dgok50/ESPNTPServer/eagle/ESPNTPServer/ESPNTPServer.brd

## EAGLE design eagle/ESPNTPServer/ESPNTPServer.brd (2026-11-04)

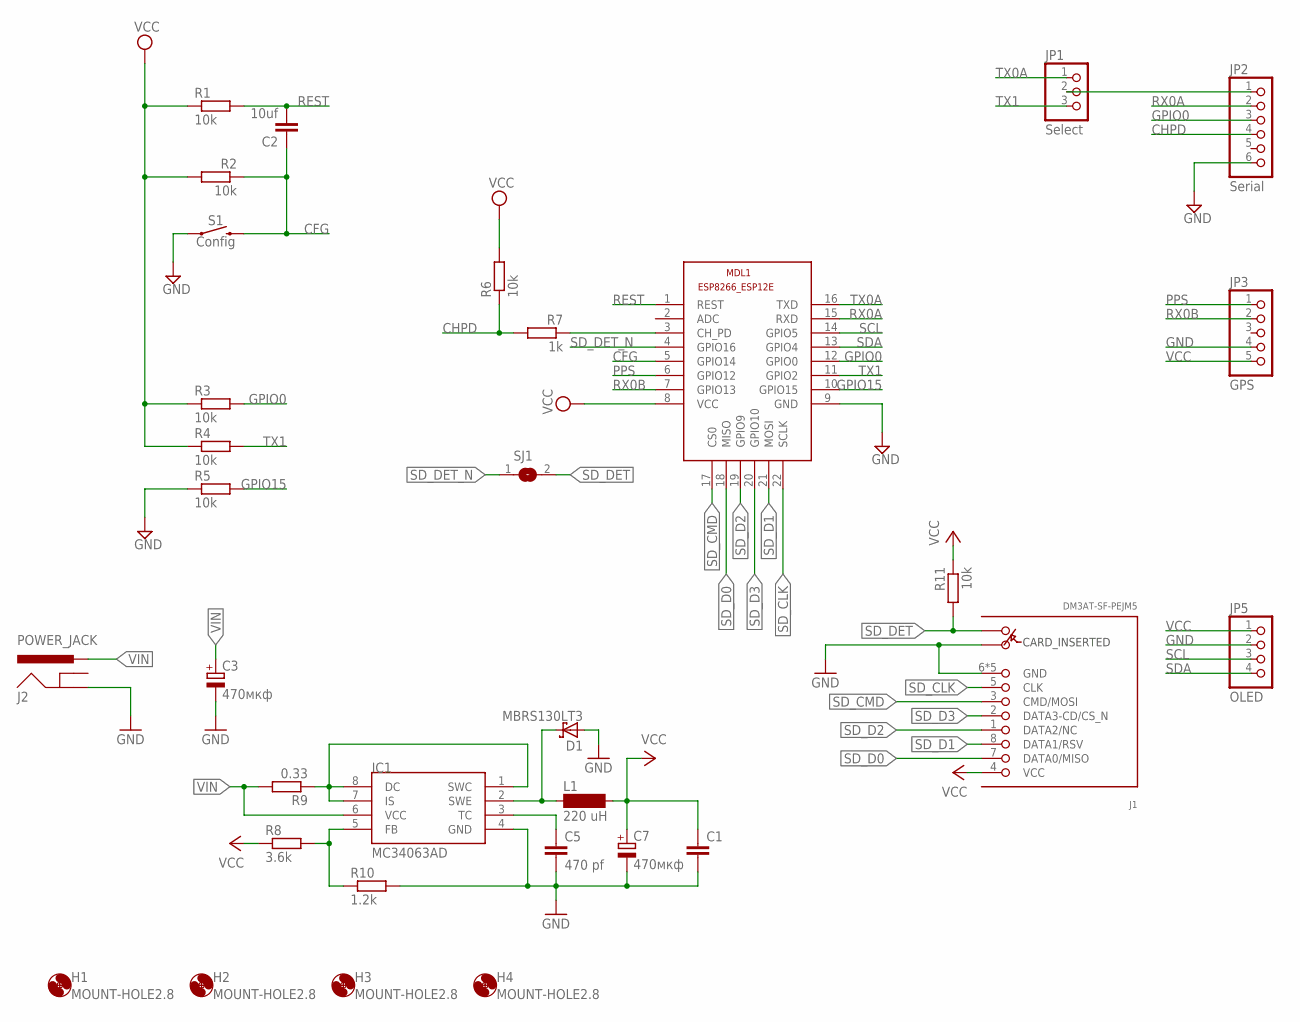
[picture p2: schematic ESPNTPServer.sch]

Parts:
C1: C-EUC1206; C1206
C2: 10uf; C050-025X075
C3, C7: 470мкф; E3,5-8
C5: 470 pf; C1206
D1: MBRS130LT3; SMB
H1, H2, H3, H4: MOUNT-HOLE2.8; 2,8
IC1: MC34063AD; SOIC8
J1: DM3AT-SF-PEJM5
J2: POWER_JACK; POWER_JACK_PTH
JP1: Select; 1X03
JP2: Serial; 1X06
JP3: GPS; 1X05
JP5: OLED; 1X04
L1: 220 uH; SD12K-82
MDL1: ESP8266-12F; ESP8266-ESP12E
R1, R2, R3, R4, R5, R6, R11: 10k; M1206
R7: 1k; M1206
R8: 3.6k; M1206
R9: 0.33; 0411V
R10: 1.2k; M1206
S1: Config; TACTILE_SWITCH_PTH_6.0MM
SJ1: SJ

Connections:
CFG: C2.1, MDL1.5 (GPIO14), R2.1, S1.3 (2)
CHPD: JP2.4, R6.1, R7.2
GND: C1.2, C3.-, C5.2, C7.-, D1.A, IC1.4 (GND), J1.6 (GND), J1.A, J1.MOUNT0 (GND), J1.MOUNT1 (GND), J1.MOUNT2 (GND), J1.MOUNT3 (GND), J2.GND, JP2.6, JP3.4, JP5.2, MDL1.9 (GND), R5.1, R10.2, S1.1
GPIO0: JP2.3, MDL1.12 (GPIO0), R3.2
GPIO15: MDL1.10 (GPIO15), R5.2
unnamed: JP1.2, JP2.1
unnamed: IC1.1 (SWC), IC1.7 (IS), IC1.8 (DC), R9.1
unnamed: C5.1, IC1.3 (TC)
unnamed: MDL1.3 (CH_PD), R7.1
unnamed: D1.C, IC1.2 (SWE), L1.1
unnamed: IC1.5 (FB), R8.2, R10.1
PPS: JP3.1, MDL1.6 (GPIO12)
REST: C2.2, MDL1.1 (REST), R1.2
RX0A: JP2.2, MDL1.15 (RXD)
RX0B: JP3.2, MDL1.7 (GPIO13)
SCL: JP5.3, MDL1.14 (GPIO5)
SDA: JP5.4, MDL1.13 (GPIO4)
SD_CLK: J1.5 (CLK), MDL1.22 (SCLK)
SD_CMD: J1.3 (CMD/MOSI), MDL1.17 (CS0)
SD_D0: J1.7 (DATA0/MISO), MDL1.18 (MISO)
SD_D1: J1.8 (DATA1/RSV), MDL1.21 (MOSI)
SD_D2: J1.1 (DATA2/NC), MDL1.19 (GPIO9)
SD_D3: J1.2 (DATA3-CD/CS_N), MDL1.20 (GPIO10)
SD_DET: J1.B, R11.2, SJ1.2
SD_DET_N: MDL1.4 (GPIO16), SJ1.1
TX0A: JP1.1, MDL1.16 (TXD)
TX1: JP1.3, MDL1.11 (GPIO2), R4.2
VCC: C1.1, C7.+, J1.4 (VCC), JP3.5, JP5.1, L1.2, MDL1.8 (VCC), R1.1, R2.2, R3.1, R4.1, R6.2, R8.1, R11.1
VIN: C3.+, IC1.6 (VCC), J2.PWR, R9.2

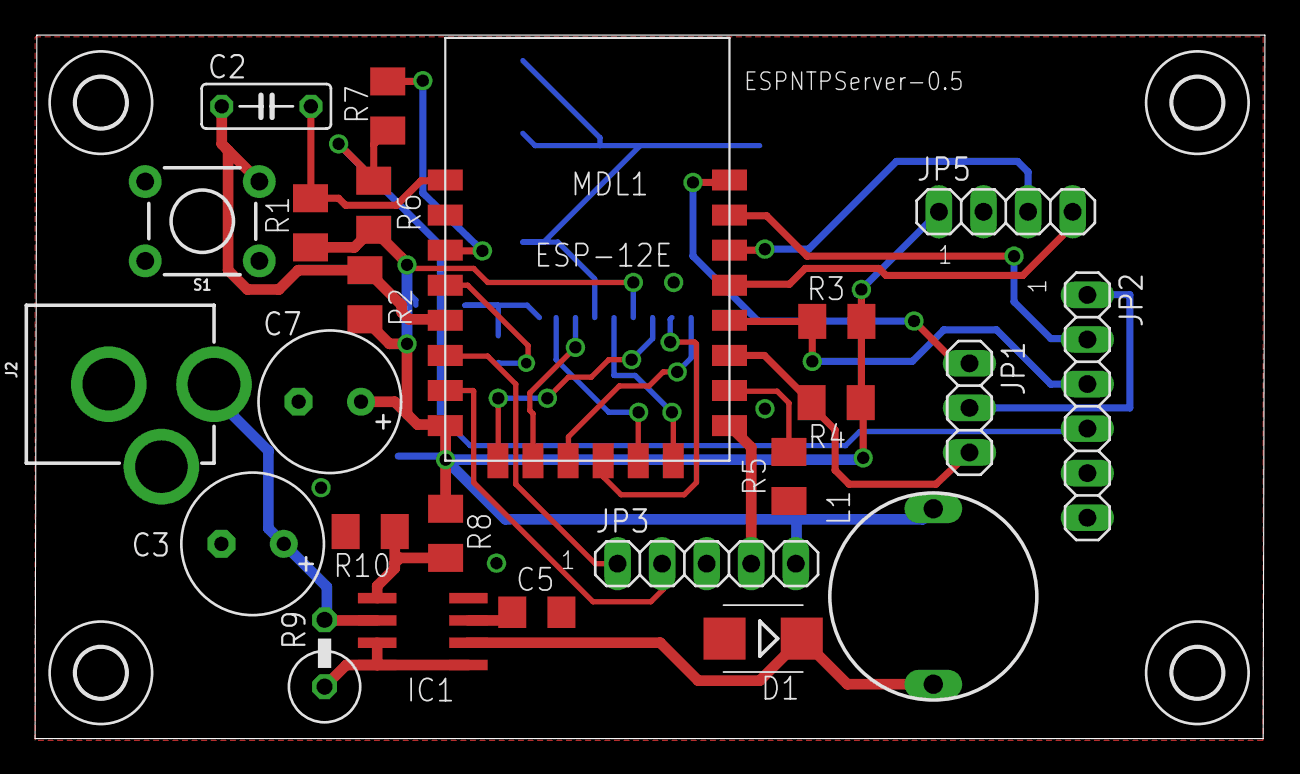
[picture p3: board ESPNTPServer.brd from above]

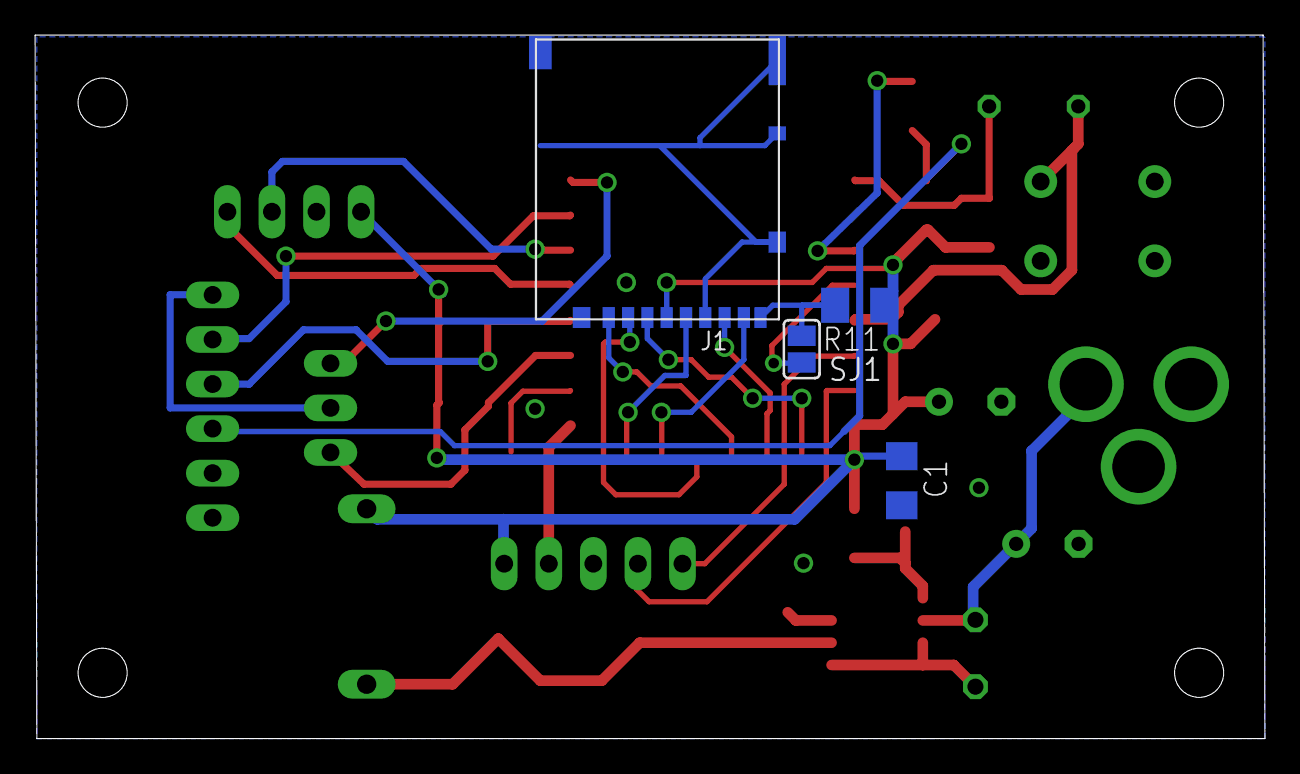
[picture p4: board ESPNTPServer.brd from below]

Board: 2 copper layers, 70.1 x 40.1 mm, 32 parts (4 on the bottom side), 29 nets.
