dgok50/ESPNTPServer/src/ESPNTPServerVersion.h

/*
 * ESPNTPServerVersion.h
 *
 *  Created on: Jun 17, 2018
 *      Author: chris.l
 */

#ifndef ESPNTPSERVERVERSION_H_
#define ESPNTPSERVERVERSION_H_

static const char ESPNTP_SERVER_VERSION[] = "1.3.7-debug";


#endif /* ESPNTPSERVERVERSION_H_ */
