dgok50/ESPNTPServer/src/DeploymentDefaults.h

#ifndef ESPNTP_DEPLOYMENT_DEFAULTS_H_
#define ESPNTP_DEPLOYMENT_DEFAULTS_H_
// Public build defaults. Protected CI builds replace this header at build time.
#define ESPNTP_DEFAULT_OTA_URL ""
#define ESPNTP_DEFAULT_SYSLOG_HOST ""
#define ESPNTP_DEFAULT_SYSLOG_PORT "0"
#endif
